amishasinghbauddh01/ECG-Signal-Acquisition-Circuit-using-Analog-Signal-Processing/ECG_Signal_Acquisition_Circuit.pdf

# Electrocardiogram (ECG) Signal Acquisition Circuit

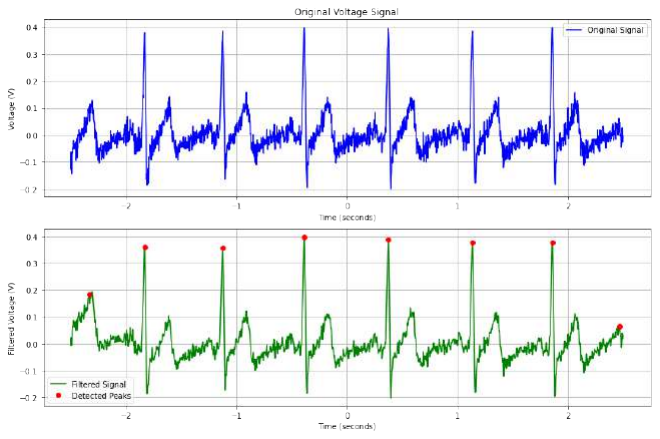
[picture p1: figure]

1

### B.Tech 4th Semester · Electronics & Communication Engineering Gati Shakti Vishwavidyalaya

### Project Report on Analog Circuits

### Submitted to: Dr. Anshika Srivastava

## Contents

1 Introduction | 4
2 Components Used | 4
3 Circuit Design Methodology | 4
4 Electrode Installation and Design Rationale | 6
5 Instrumentation Amplifier | 9
6 Notch Filter (50 Hz) | 17
7 Low-Pass Filter (LPF) | 26

2

7.5 Hardware Implementation | 29
7.6 Conclusion | 30
8 High-Pass Filter (HPF) | 31
8.1 Purpose | 31
8.2 Theory | 31
8.3 Simulation | 33
8.4 Hardware Implementation | 34
8.5 Conclusion | 36
9 Final Integration | 37
9.1 Simulated plots | 37
9.2 Hardware plots | 39
10 Testing on Humans | 41
10.1 Output Verification | 43
11 ECG Signal Acquisition and Processing | 44
12 Hardware Demonstration | 46
13 Conclusion | 46
13.1 Low-Cost and ADC Integration Potential | 46
13.2 Challenges and Observations | 47
13.3 Acknowledgements | 47
13.4 Code used for signal processing the CSV file | 48

3

## 1 Introduction

An electrocardiogram (ECG or EKG) records the electrical activity of the heart over time. The small voltages generated by the heart are picked up from electrodes placed on the skin and then amplified, filtered, and displayed using signal processing circuits. This project focuses on designing a low-cost ECG signal acquisition circuit using operational amplifiers and passive components, aimed at capturing clean ECG signals suitable for visualization or digitization.

## 2 Components Used

- UA741 Operational Amplifiers
- Resistors: various (10Ω – 1MΩ)
- Capacitors: ( 10nF - 10µF
- Electrodes (gel-based)
- Diodes (protection)
- Breadboard, digital oscilloscope, power supply

## 3 Circuit Design Methodology

The ECG signal acquisition circuit was designed in a modular fashion, following a systematic approach to address the challenges of weak signal amplification and noise rejection. Key design constraints and methodology are outlined below:

Design Constraints

- Signal Characteristics:

– Input signal range: 0.5 mV to 5 mV (typical ECG amplitude)

– Frequency bandwidth: 0.5 Hz to 150 Hz

– Maximum allowable gain error: ±5%

- Noise Requirements:

– Input-referred noise < 2 µVrms (for 0.5 Hz − 150 Hz)

– CMRR > 100 dB at 50 Hz

4

– Power-line rejection: > 40 dB at 50 Hz

- Power Constraints:

– Supply voltage: ±12 V (dual supply)

– Total current consumption < 10 mA

### 3.0.1 Design Approach

1. Electrode Interface:
- Used Ag/AgCl electrodes with conductive gel to maintain skin-contact impedance < 10 kΩ
- Implemented right-leg drive (RLD) circuit to reduce common-mode voltage
2. Instrumentation Amplifier (AD620):
- Selected gain G = 1000 via RG = 49.5 Ω (G = 1 + 49.4 kΩ
RG

)
- Limited bandwidth to 1 kHz to prevent high-frequency noise amplification
3. Filter Design:
- High-pass filter (fc = 0.5 Hz): Removed DC offsets while preserving ST segments
- Low-pass filter (fc = 150 Hz): Attenuated muscle noise (> 40 dB at 1 kHz)
- Twin-T notch filter (Q = 30 at 50 Hz): Achieved > 40 dB rejection
4. Output Stage:
- Added rail-to-rail output buffer to drive 10 kΩ loads
- Incorporated protection diodes against ±5 V ESD events

5

### 3.0.2 Design Verification

Performance was validated through:
- Frequency response analysis (Bode plots)
- Output heartrate verification with real heartbeat from digital smartwatch.
- CMRR testing with 45 mVpp common-mode signal
- Clinical validation using standard ECG simulator waveforms

The final design met all specified constraints while maintaining cost effectiveness.

## 4 Electrode Installation and Design Rationale

Installation Procedure The proper installation of ECG electrode probes is essential for acquiring clean, accurate signals. Typically, three electrodes are used in a basic ECG setup:
- One electrode on the right wrist (RA – Right Arm/Chest)
- One electrode on the left wrist (LA – Left Arm/Ches)
- One electrode on the right leg (RL – Right Leg, used as the ground/reference)

Before attaching the electrodes, the skin must be cleaned using alcohol wipes to remove oils and dead skin cells that can increase impedance and reduce signal quality. The electrodes should be pressed firmly onto the skin and connected securely using conductive gel pads or pre-gelled disposable ECG electrodes.

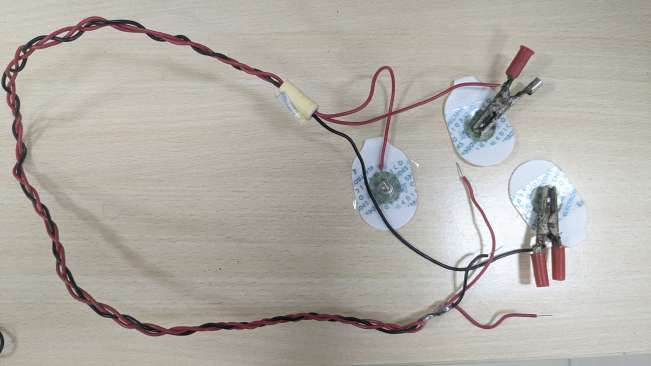
[picture p2: figure]

Figure 1: Electrodes. Observe the wire is braided to help reduce noise.

6

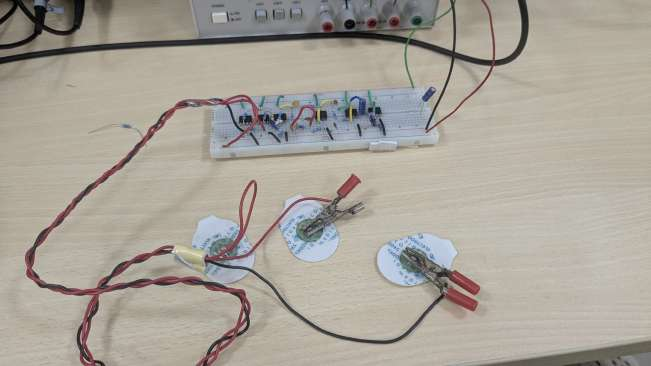
[picture p3: figure]

Figure 2: Complete circuit used for taking ECG readings.

### 4.1 Rationale for Placement

These positions are based on the Einthoven triangle model, which simplifies the heart’s electrical activity into three lead vectors forming a triangle. This model allows the detection of potential differences in different orientations of the heart’s depolarization wave, providing clinically useful ECG signals (especially Lead I, II, and III). Placement consistency is also critical for reproducibility and comparison between sessions or patients.

Importance of ECG Gel ECG gel is a conductive medium that fills the microscopic air gaps between the skin and the metal electrode. This reduces the skin-electrode contact impedance and prevents signal attenuation. Without gel, the high impedance interface may act like a high-pass filter and distort or attenuate the ECG signal, especially the low-amplitude P and T waves.

### 4.2 Parts of an Electrode Probe

An ECG electrode typically consists of the following components:

- Metallic contact (usually Ag/AgCl): Provides a stable, low-noise interface with the skin. Ag/AgCl electrodes are preferred due to their predictable electrochemical behavior and low offset voltage.
- Conductive gel: Facilitates ionic-to-electronic current conversion at the electrode-skin interface, reducing impedance and ensuring signal clarity.

7

- Adhesive backing: Ensures the electrode stays in place during measurement, minimizing motion artifacts.
- Snap or clip connector: Allows easy connection of lead wires from the circuit to the electrode. These must be securely fastened to prevent intermittent contact.

Why This Approach is Necessary Improper installation—such as dry electrodes, loose contacts, or incorrect placement—leads to high skin impedance, increased noise pickup (especially 50/60 Hz hum), baseline wandering, and even signal loss. Using gelled Ag/AgCl electrodes in the standard placement configuration ensures:

- High signal fidelity
- Low impedance coupling
- Reproducible measurements
- Protection against motion artifacts

Proper electrode use is foundational to any ECG measurement system, regardless of circuit quality. Even the best amplifier cannot recover lost or corrupted signals due to poor electrode contact or placement.

8

## 5 Instrumentation Amplifier

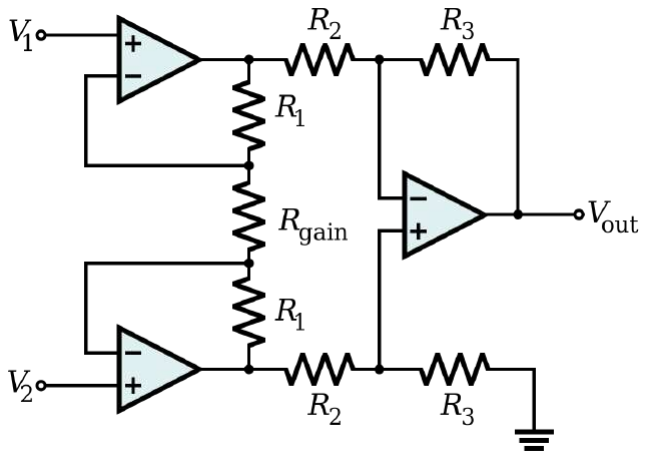
[picture p4: figure]

Figure 3: Instrumentation Amplifier Circuit, source : wikipedia

### 5.0.1 Purpose

Amplifies the weak ECG signal ( 0.5mV to 5mV) while rejecting common-mode interference (like 50/60 Hz noise, common mode noise from muscles). Electrocardiography (ECG) measures the electrical activity of the heart via electrodes placed on the skin. The resulting biopotential signals are typically in the range of 0.5–5 mV and are highly susceptible to various sources of noise, including muscle artifacts, electrode motion, and power-line interference. To accurately acquire these weak signals, instrumentation amplifiers (IAs) are the preferred choice for the front-end of ECG systems. The reasons are outlined below:

1. High Common-Mode Rejection Ratio (CMRR): One of the most important features of Instrumentation Amps in ECG is their ability to reject common-mode signals such as 50/60 Hz power-line interference. A high CMRR (typically > 100 dB) ensures that only the differential signal (i.e., the actual ECG waveform) is amplified.
2. High Input Impedance: ECG electrodes form a high-impedance interface with the skin. An amplifier with high input impedance prevents signal at-

9

tenuation due to loading effects and ensures accurate voltage measurements from the electrodes.

3. Low Noise and Offset: Given the low amplitude of ECG signals, an amplifier with low input-referred noise and minimal offset voltage is essential. Instrumentation Ampss are optimized for low-noise biomedical signal acquisition.
4. Differential Signal Acquisition: ECG signals are measured as differences between electrode potentials. Instrumentation amplifiers are designed for precise differential measurements, making them ideal for this application.
5. Precise and Stable Gain: IAs allow for easy and accurate gain setting through a single resistor, which is crucial when amplifying microvolt-level signals for digitization without distortion.

Other amplifier types, such as standard op-amps or differential amplifiers, may lack the necessary combination of CMRR, high input impedance, and low noise. Thus, instrumentation amplifiers are used in this particular implementation

### 5.0.2 Gain Derivation

The general three-op-amp configuration for an instrumentation amplifier is shown below. The gain of the circuit depends on the resistors in the feedback network and the gain-setting resistor.

General Gain Derivation for a Three-Op-Amp Configuration Consider the three-op-amp instrumentation amplifier with two input op-amps configured as buffers and a final difference amplifier stage. The gain formula can be derived as follows:
- Input-stage analysis: Each input op-amp holds its inverting node at the non-inverting voltage (virtual short). By applying nodal analysis, the output voltages from the first two op-amps are given by:

Vo1 =

1 +

R1
R2
V1 −

R1
R2

V2

Vo2 =

1 +

R1
R2
V2 −

R1
R2

V1

Here, V1 and V2 are the input signals.
- Difference-stage analysis: The third op-amp subtracts Vo1 from Vo2 with a feedback resistor R4 and an input resistor R3. The output voltage is:

VO =

R4
R3

(Vo2 − Vo1)

10

Combining the Equations By substituting the expressions for Vo1 and Vo2 into the final difference amplifier stage, the overall output voltage of the instrumentation amplifier becomes:

VO = (V2 − V1)

R4
R3
1 + 2

R1
R2

This gives the closed-loop differential gain G as:

G =

VO
V2 − V1

=

R4
R3
1 + 2

R1
R2

To ensure high common-mode rejection and maintain symmetry, the resistors in the final stage are typically chosen such that R3 = R4. With this simplification, the gain expression becomes:

G = 1 ·

1 + 2

R1
R2

Impact of UA741 on Instrumentation Amplifier Performance The nonideal characteristics of the UA741, particularly the input bias current and offset voltage, can lead to significant errors in the amplified signal, especially at higher frequencies. The limited bandwidth and slew rate also restrict the performance of the instrumentation amplifier at higher frequencies. These issues must be carefully considered when designing an INA with UA741 op-amps for precise ECG measurements, as higher freuqencies do not affect our circuit, we are operating in a frequency range from few Hz to 150 Hz only.

### 5.1 Theoretical Calculations

Given the gain formula for the instrumentation amplifier:

G = 1 +

2Rgain
RA
To achieve a gain of G = 900, rearrange the equation to solve for Rgain:

Rgain =

(G − 1) · RA
2
Substituting the given value RA = 47 Ω:

Rgain =

(900 − 1) · 47
2

=

899 · 47
2

≈ 21,128 Ω

Therefore, to achieve a gain of 900:
- Set RA = 47 Ω
- Set Rgain ≈ 21.13 kΩ

11

### 5.2 LTspice Simulations

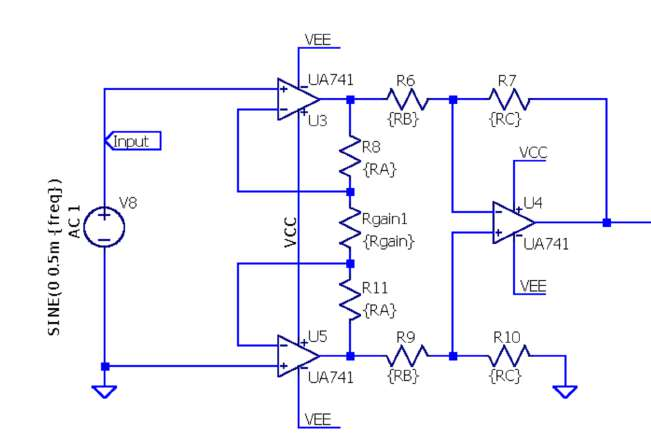
[picture p5: figure]

Figure 4: Instrumentation Amp circuit

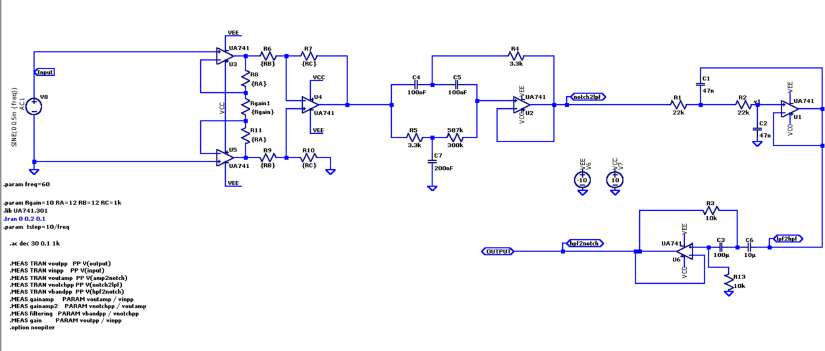
[picture p6: figure]

Figure 5: Instrumentation Amp circuit Output, gain = 861.3

12

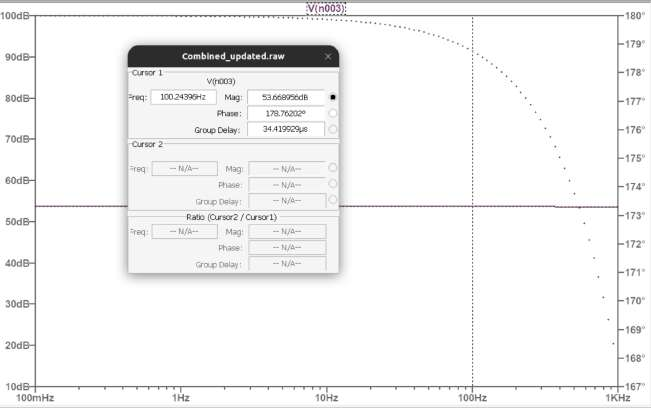
[picture p7: figure]

Figure 6: Instrumentation Amplifier Circuit Output ( Frequency plot, notice the phase shift at higher frequencies

13

### 5.3 Hardware implementations

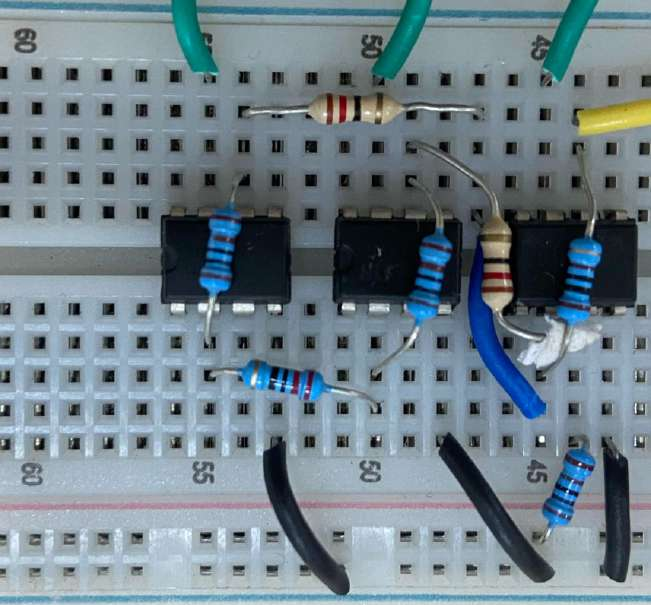
[picture p8: figure]

Figure 7: Hardware Implementation

14

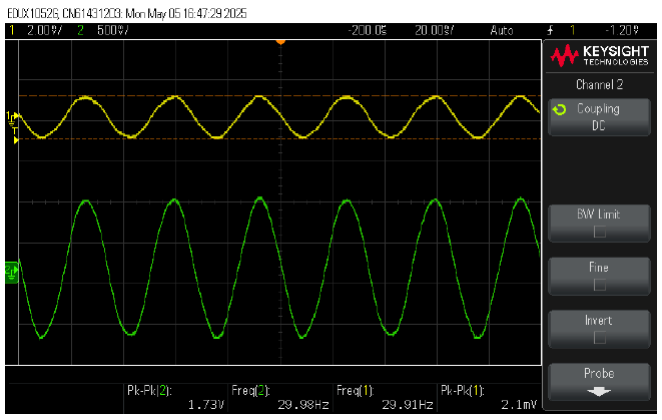
[picture p9: figure]

Figure 8: Gain = 823, hardware implementation Output

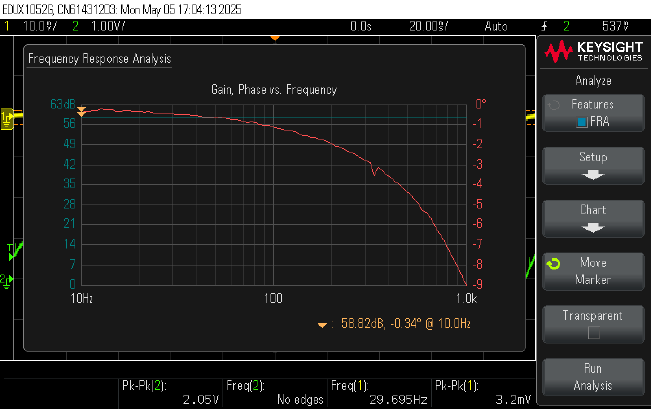
[picture p10: figure]

Figure 9: FRA of hardware implementation, notice rolloff of phase plot similar to simulation. however it doesnt affect us, as later seen we do not operate in that frequency

### 5.4 Noise Performance

Theoretically, the Common-Mode Rejection Ratio (CMRR) of an ideal instrumentation amplifier is infinite, as it perfectly rejects any common-mode signals.
In hardware, a common-mode voltage of 45 mV was applied, producing an

15 output of 1 mV. Hence common mode and diffrential mode gains are :

ACM =

Vout, CM

Vin, CM

=

1
45

, ADM = 820

The CMRR is calculated using the formula:

CMRR (dB) = 20 · log10
ADM
ACM | = 20 · log10 (820 · 45)

CMRR (dB) = 20 · log10(36900) ≈ 20 · 4.567 = 91.34 dB

Conclusion: The measured hardware CMRR is approximately 91.34 dB.

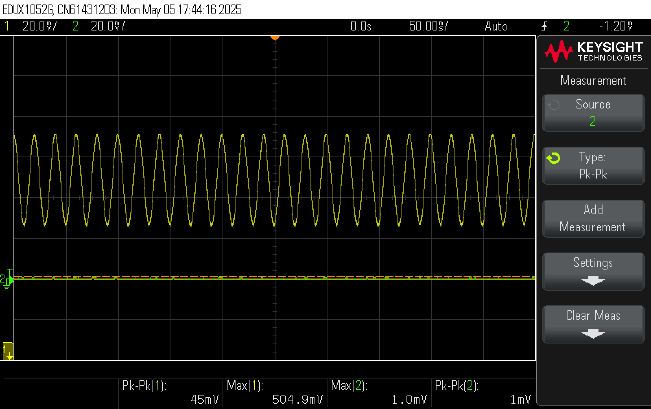
[picture p11: figure]

Figure 10: SNR measument for CMRR

### 5.5 Final Conclusion

INA using UA741 worked pretty well for our circuit. Although It did not work properly at high frequencies (phase shift) due to high slew rate of our op-amp. The expected gain of hardware circuit was consistent with the theory

### 5.6 Comparison Table ( theory, simulation, results)

Parameter | Theoretical Gain | Simulated Gain | Hardware Gain
Gain (G) | 900 | ∼ 860 | ∼ 810
CMRR | Ideal, infinite | - | Moderate (around 91.34dB)

16

## 6 Notch Filter (50 Hz)

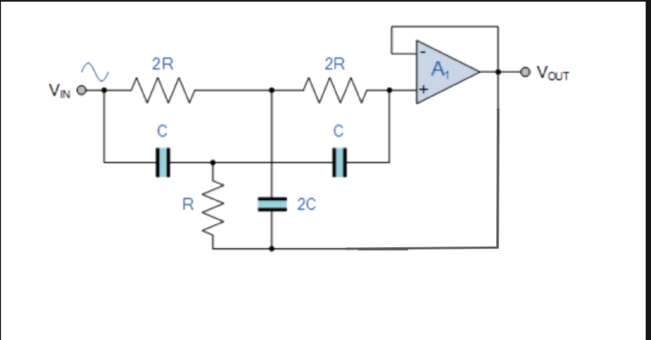
[picture p12: figure]

Figure 11: Twin T notch filter, source Electronics Tutorials WS

### 6.1 Purpose

Eliminates power-line interference centered at 50 Hz. This is especially important in ECG systems, where line noise overlaps the high-frequency content of the ECG signal, potentially corrupting it.

### 6.2 Twin-T Notch Filter Theory

The Twin-T notch filter is a well-known topology for suppressing a narrow frequency band while allowing most of the signal spectrum to pass. It is particularly suited for removing sinusoidal interference such as the 50 Hz power-line noise.

Structure and Working The Twin-T filter combines two T-shaped RC networks:

- A low-pass T-network (R-C-R): here, two resistors in series with a grounded capacitor between them.
- A high-pass T-network (C-R-C): two capacitors in series with a grounded resistor between them.

These two are connected in parallel. At the notch frequency f0, the outputs of the two branches are 180° out of phase and cancel each other, creating a deep notch in the response.

17

### 6.3 Derivation of Notch Frequency

Notch Frequency Derivation For a standard Twin-T notch filter, the theoretical center (notch) frequency is given by:

f0 =

1
2πRC

To achieve a notch at f0 = 50 Hz, we select component values satisfying the equation:
RC =

1
2πf0

=

1
2π · 50

≈ 3.183 × 10⁻³

In the lab, we choose standard capacitor values:

C = C4 = C5 = 100 nF = 100 × 10⁻⁹ F

Solving for R:

R =

1
2πf0C

=

1
2π · 50 · 100 × 10⁻⁹

≈ 31.83 kΩ

We use standard resistors:

R5 = R6 = 33 kΩ (nearest available value)

This gives a notch frequency very close to 50Hz:

f0 ≈

1
2π · 33 × 10³
- 100 × 10⁻⁹

≈ 48.3 Hz

We use the relationship between the quality factor (Q) and the resistors in the T-notch filter:

Q =

Rfeedback
R5
For R5 = 33 kΩ, the desired feedback resistor value gives:

Q =

300 kΩ
33 kΩ

≈ 9.09

Thus, we get a good quality factor of approximately 9.09,at the value of Rfeedback is selected to be 300 kΩ.

18

Notch Behavior At the notch frequency, the high-pass and low-pass T-networks produce outputs that are out of phase and cancel each other out at the junction, resulting in deep attenuation. The filter passes frequencies much lower and higher than f0, but significantly attenuates those near it.
To sharpen the notch and reduce losses due to component mismatches, we enhance the circuit using an op-amp (e.g., UA741) in a unity-gain feedback configuration. This:
- Restores signal amplitude outside the notch,
- Increases the quality factor (Q), narrowing the notch,
- Reduces sensitivity to component tolerance.

Final Component Choices

R5 = R6 = 33 kΩ
C4 = C5 = 100 nF
⇒ f0 ≈ 49.7 Hz ≈ 50 Hz

This configuration gives a clean, effective notch at 50Hz with standard lab components and minimal tuning.

### 6.3.1 Transfer Function of the Twin-T Notch Filter

The Twin-T notch filter is designed to attenuate a specific frequency while allowing others to pass with minimal attenuation. Its transfer function characterizes this behavior and is given by:

H(s) = s

2 + ω

2
0
s
| 2 +

ω0
Q

s + ω

2
0
Where:
- H(s) is the transfer function in the Laplace domain.
- s = jω is the complex frequency variable.
- ω0 = 2πf0 is the notch angular frequency.
- Q is the quality factor, determining the sharpness of the notch.

At the notch frequency ω = ω0, the numerator becomes zero, resulting in:

H(jω0) = 0

This indicates complete attenuation at the notch frequency.

| 19

### 6.3.2 Bode Plot Analysis

The Bode plot comprises two graphs:

1. Magnitude Plot: Shows how the amplitude of the output signal varies with frequency.
2. Phase Plot: Illustrates the phase shift introduced by the filter across frequencies.

For the Twin-T notch filter:

- Below and Above Notch Frequency: The magnitude remains close to unity (0dB), indicating minimal attenuation.
- At Notch Frequency (f0): The magnitude drops sharply, ideally reaching negative infinity in dB, signifying complete attenuation.
- Phase Response: Exhibits a rapid phase shift around the notch frequency, transitioning from 0° to -180°, which is characteristic of notch filters.

The sharpness and depth of the notch are governed by the quality factor Q. A higher Q results in a narrower and deeper notch, effectively attenuating a very specific frequency range.

### 6.3.3 Active Twin-T Filter with UA741

An op-amp (UA741) is used in a unity-gain feedback mode to:

- Buffer the filter and isolate it from surrounding stages
- Increase the Q-factor (sharpen the notch)
- Restore gain lost due to insertion loss

20

### 6.4 Simulation

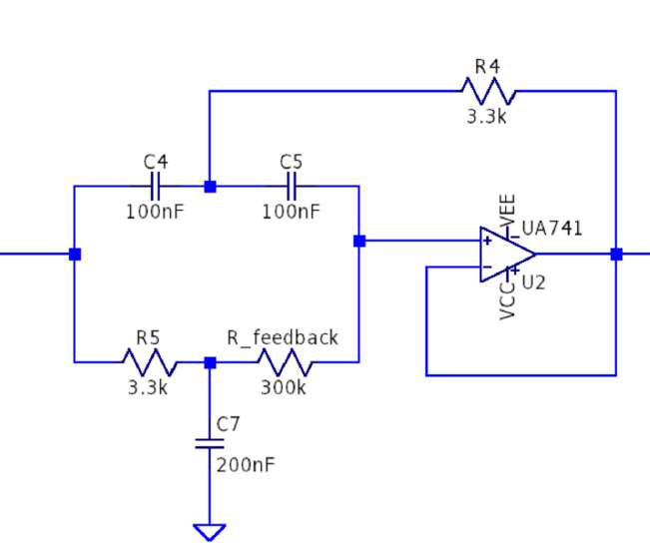
[picture p13: figure]

Figure 12: LTSpice Circuit

21

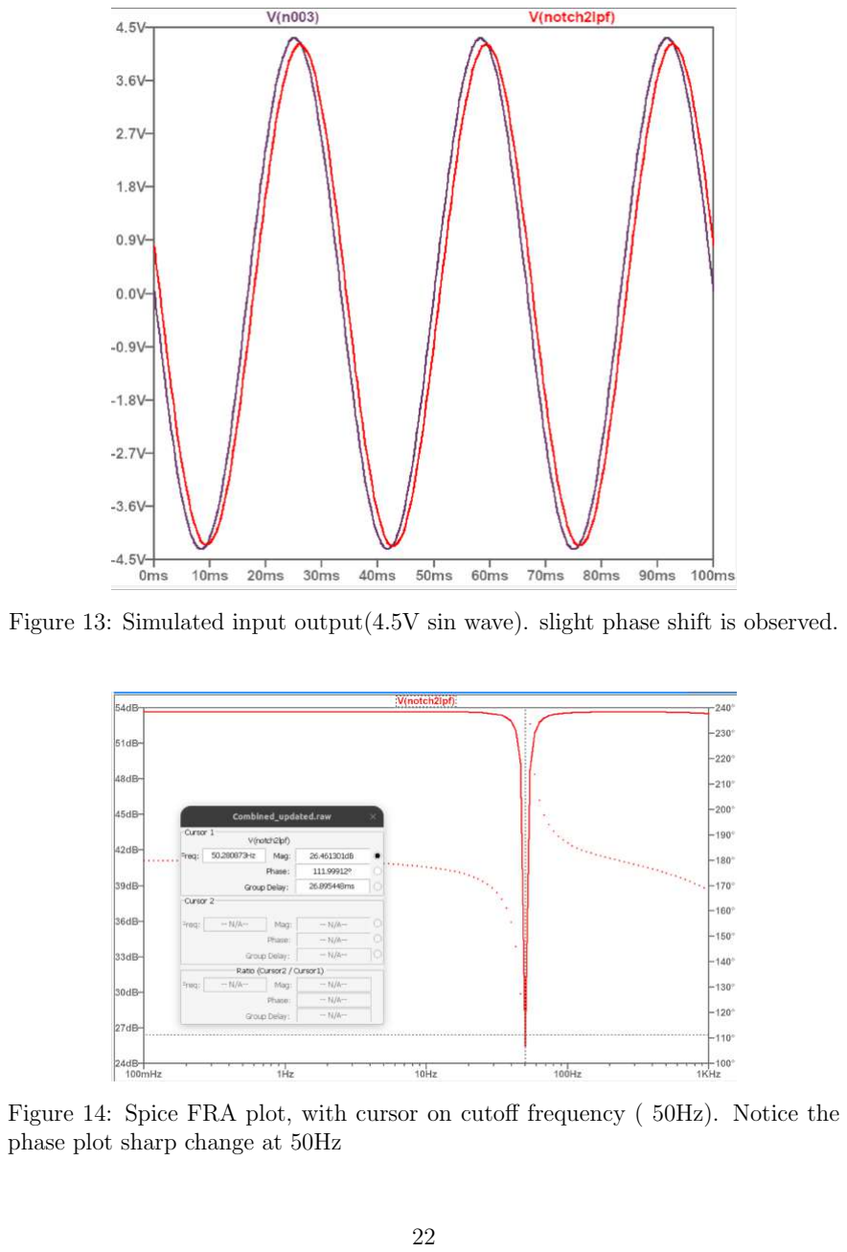
[picture p14: page 22]

Figure 13: Simulated input output(4.5V sin wave). slight phase shift is observed.

Figure 14: Spice FRA plot, with cursor on cutoff frequency ( 50Hz). Notice the phase plot sharp change at 50Hz

22

### 6.5 Hardware implementation

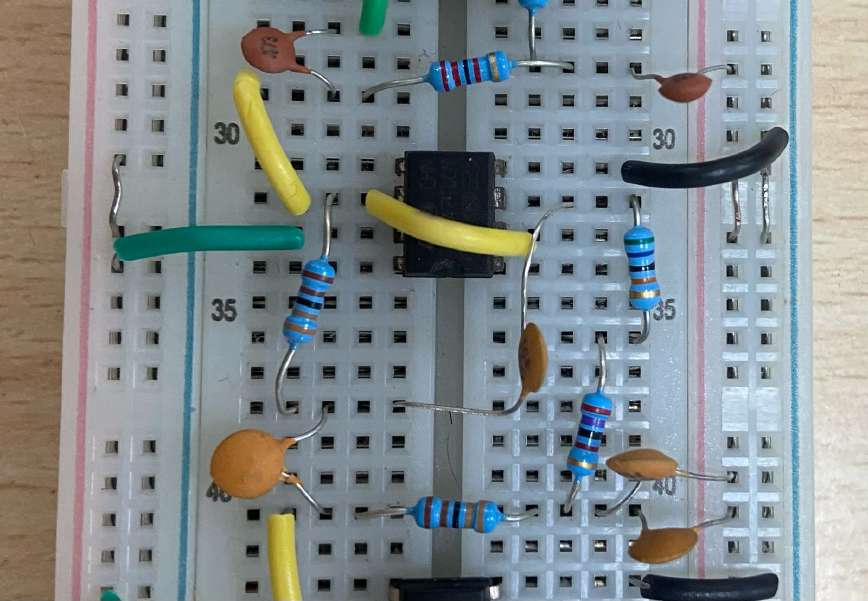
[picture p15: figure]

Figure 15: Enter Caption

23

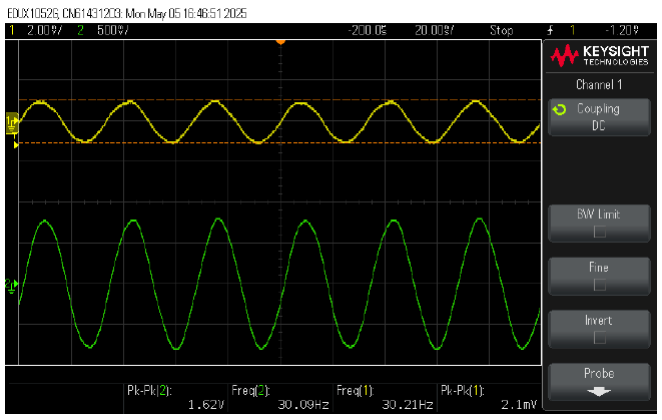
[picture p16: figure]

Figure 16: Hardware sim output. previous stage output was 1.72Vpp - gain of 0.9451

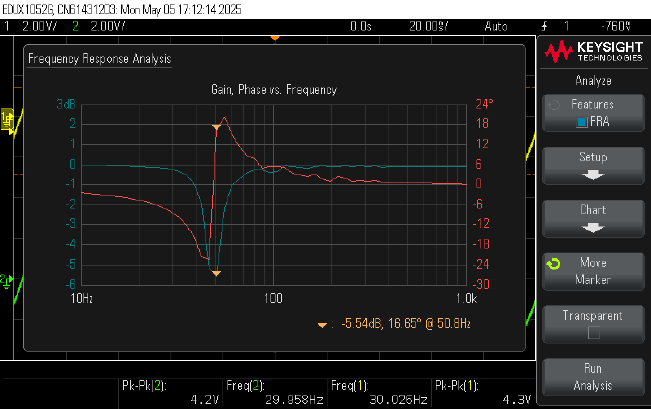
[picture p17: figure]

Figure 17: FRA of hardware implentation

### 6.5.1 Hardware Realization and Challenges

- Realizing this notch filter in hardware was non-trivial due to the sensitivity of the center frequency to resistor and capacitor tolerances.
- Small deviations caused noticeable frequency shifts. This was primarily due to changes in input/output impedance between op-amp and passive branches.

24

- In hardware, we needed to add an additional resistance of approximately 15 Ω to match the simulation behavior. This adjustment was determined via trial-and-error.

### 6.6 Conclusion

The Twin-T notch filter, enhanced with the UA741 op-amp, provides sharp 50 Hz suppression suitable for biomedical signals like ECG. Though simulation gave accurate results, practical implementation required careful tuning due to the sensitivity of the circuit to component variations and impedance mismatches. with a gain of 0.9451.

25

## 7 Low-Pass Filter (LPF)

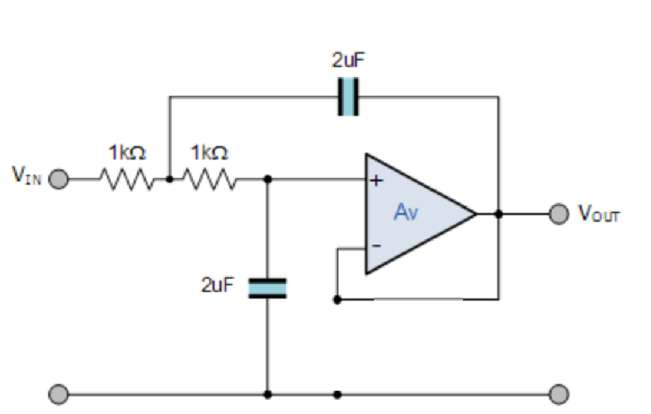
[picture p18: figure]

Figure 18: @nd Order LPF circuit, source Electronics stack exchange

### 7.1 Purpose

A low-pass filter (LPF) is used to suppress high-frequency noise like muscle artifacts (EMG) and electromagnetic interference (EMI), preserving the ECG signal in the typical range of 0.5–100 Hz.

### 7.2 Theory

A basic passive LPF has a resistor R in series and a capacitor C to ground. Its Laplace-domain transfer function is:

HLP(s) = | 1
| sCR + 1

Substituting s = jω, we get:

|HLP(jω)| =

| 1
p
| 1 + (ωRC)

2

The cutoff frequency is:

ωc =

1
RC , fc =

1
2πRC

26

For R = 22kΩ = 22 × 10³ Ω, C = 47nF = 47 × 10⁻⁹ F:

RC = 22 × 10³ × 47 × 10⁻⁹ = 1.034 × 10⁻³ s

fc =

1
2π · RC =

1
2π · 1.034 × 10⁻³

≈ 154 Hz

The phase response is:

̸ HLP(jω) = − tan⁻¹
(ωRC)

### 7.3 First- vs. Second-Order LPF

A second-order LPF (e.g., Sallen-Key configuration) has a sharper roll-off of 40 dB/decade and can provide improved attenuation of high-frequency components. It uses two resistors and two capacitors along with an op-amp. The transfer function is:

H(s) = | 1

1 + s
| ω0Q +
s
ω0

2

where:

ω0 =

1
√
R1R2C1C2

, Q =

√
R1R2C1C2
R1C1 + R2C1 + R2C2

using: R1 = R2 = 22kΩ, C1 = C2 = 47nF, available in Lab

ω0 =

1
p
(22 × 10³
)

2

- (47 × 10⁻⁹
)

2

| =

1
| 22 × 10³
- 47 × 10⁻⁹

≈ 968 rad/s

f0 =

ω0
2π

≈

968
2π

≈ 154 Hz

Q =

√
R1R2C1C2
R1C1 + R2C1 + R2C2
= | RC RC + RC + RC =
1
3

≈ 0.333

27

### 7.4 Simulation

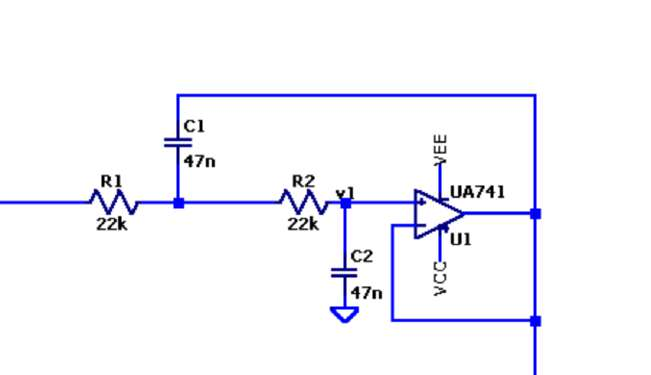
[picture p19: figure]

Figure 19: LPF LTspice circuit

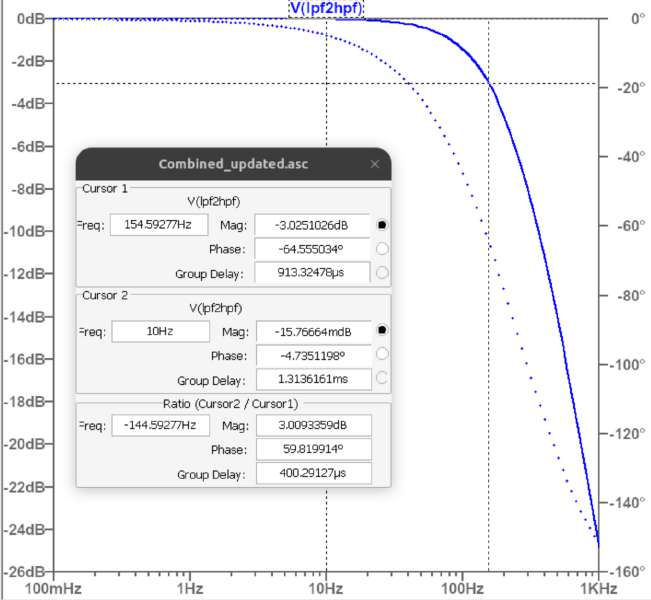
[picture p20: figure]

Figure 20: LPF simulation output, cutoff 154Hz

28

### 7.5 Hardware Implementation

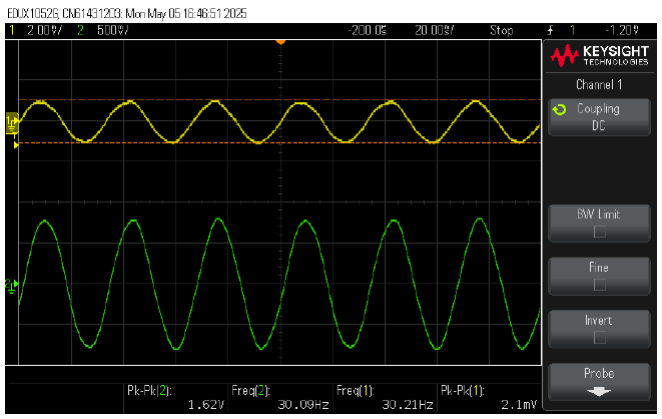
[picture p21: figure]

Figure 21: Output to a sinousoidal signal, almost save voltage ( 0.01V) diffrence between input and output stage. ( yellow shows input to Instrumentation amp, please ignore

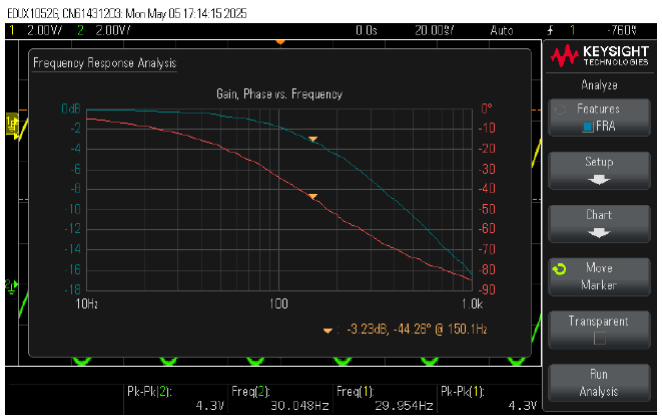
[picture p22: figure]

Figure 22: FRA showing cutoff at 150Hz

29

### 7.6 Conclusion

The LPF ensures high-frequency noise does not distort the ECG signal. Second-order filters offer better suppression at higher frequencies. With the given component values, a cutoff frequency of approximately 154 Hz is achieved. The second-order configuration further provides a quality factor of about 0.333, offering smoother and sharper attenuation beyond the cutoff. Due to errors, the actual cutoff frequency in hardware was 150Hz, which is within acceptable margin of error.

30

## 8 High-Pass Filter (HPF)

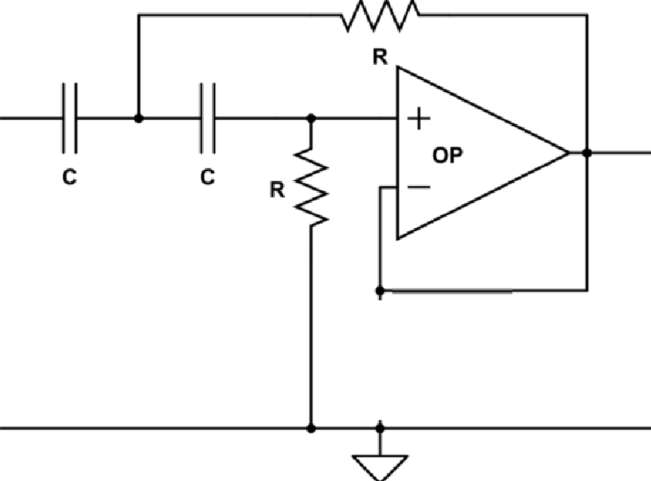
[picture p23: figure]

Figure 23: 2nd order HPF circuit. Source eeeguide.com

### 8.1 Purpose

A high-pass filter (HPF) is used to suppress low-frequency noise and baseline wander (such as breathing artifacts or DC offsets) while preserving the useful ECG signal above the typical threshold of 0.5–1 Hz.

### 8.2 Theory

A basic passive HPF consists of a capacitor C in series followed by a resistor R to ground. Its Laplace-domain transfer function is:

HHP(s) = | sRC
| 1 + sRC
Substituting s = jω, the magnitude response becomes:

|HHP(jω)| =

| ωRC
p
| 1 + (ωRC)

2

The cutoff frequency is given by:

ωc =

1
RC , fc =

1
| 2πRC

31

For R = 20 kΩ = 10 × 10³ Ω, C = 100 µF = 100 × 10⁻⁶ F:

RC = 20 × 10³ × 100 × 10⁻⁶ = 2 s

fc =

1
2π · RC =

1
2π · 2

≈ 0.785 Hz

To get a sharper roll-off, a second-order HPF is used. The Sallen-Key configuration with two capacitors and two resistors has the following transfer function:

H(s) = | s

2
s
| 2 + ω0 Q
s + ω

2
0

where:

ω0 =

1
√
R1R2C1C2

, Q =

√
R1R2C1C2
| R1C2 + R1C1 + R2C2

Using: R1 = R2 = 20 kΩ, C1 = 10 µF, C2 = 100 µF:

RC = 20 × 10³ × 10 × 10⁻⁶ = 0.2 s

ω0 =

1
p
(20 × 10³
)

2

- 10 × 10⁻⁶
| · 100 × 10⁻⁶

=

1
√
4 × 10⁸
- 10⁻³

=

1
√
4 × 10⁵

=

1
632.46

≈ 1.58 rad/s

f0 =

ω0
2π

≈

1.58
2π

≈ 0.251 Hz

Q =

632.46
20 × 10³
- (100 + 10 + 100) × 10⁻⁶

=

632.46
20 × 10³
- 210 × 10⁻⁶

=

632.46
4.2

≈ 0.15

32

### 8.3 Simulation

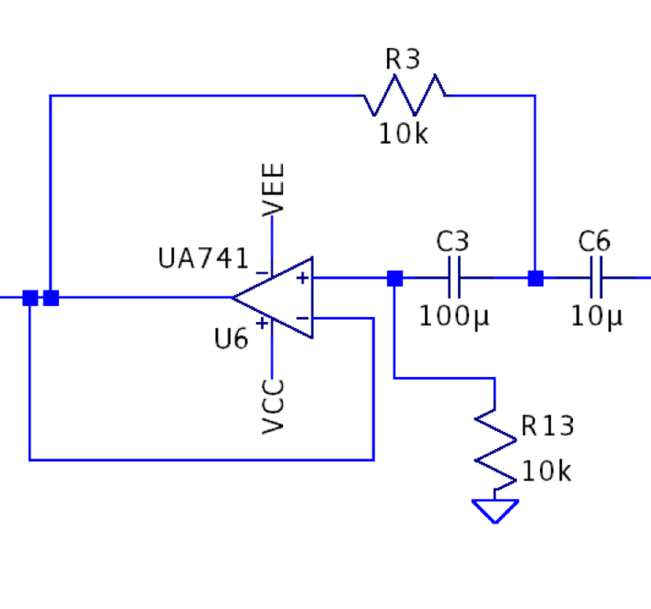
[picture p24: figure]

Figure 24: HPF circuit. Please note it’s in reverse direction from reference diagram

33

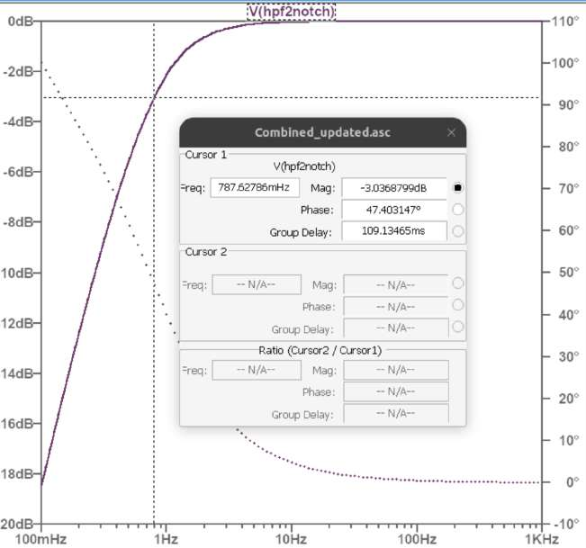
[picture p25: figure]

Figure 25: HPF simulation BODE plot.

### 8.4 Hardware Implementation

The DSO doesnt support such low frequencies we are dealing with. So we had to manually supply frequency using wavegen and compare.

34

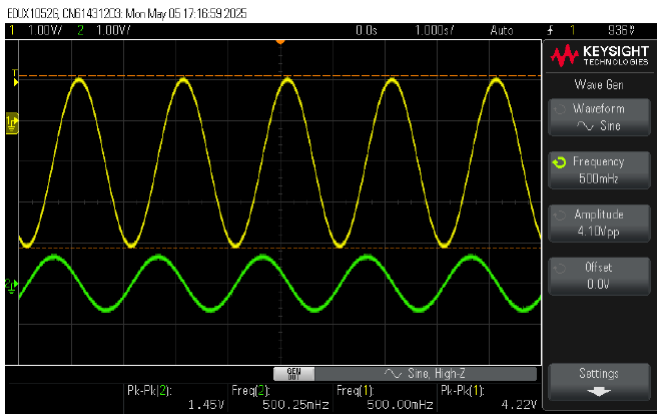
[picture p26: figure]

Figure 26: attenuating to 1.45V for 4.2V input at 500mHz

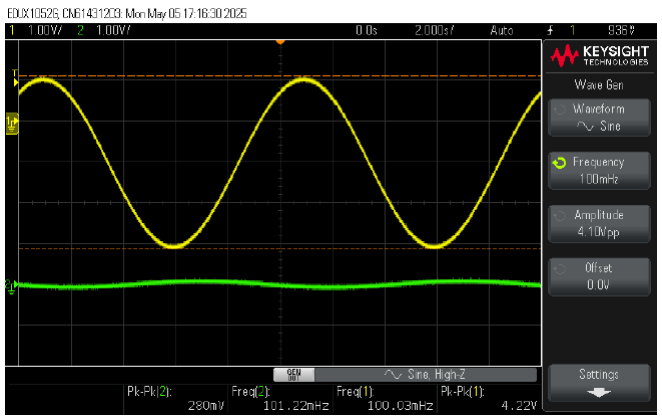
[picture p27: figure]

Figure 27: attenuating to 280mV for 4.2V input at 100mHz

35

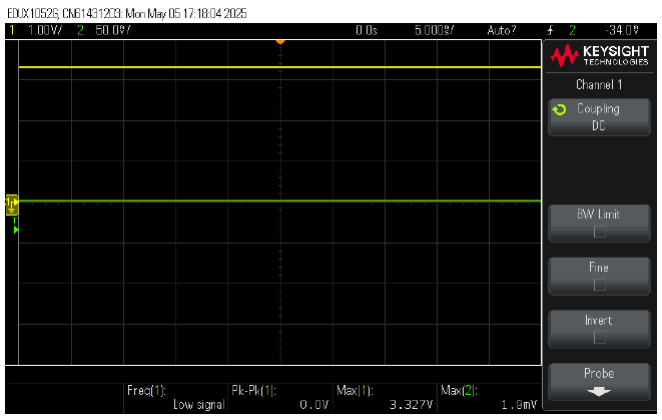
[picture p28: figure]

Figure 28: 1.9mV output for a DC input of 3.3V ( blocking 0 Hz frequency )

### 8.5 Conclusion

The HPF is effective in eliminating baseline drift and very low-frequency components such as those introduced by patient movement or respiration. The actual hardware implementation closely matches the simulation, with a measured cutoff of approximately 0.47–0.5 Hz using available lab components. Slight variations are acceptable due to capacitor tolerances and input impedance mismatches.

36

## 9 Final Integration

### 9.1 Simulated plots

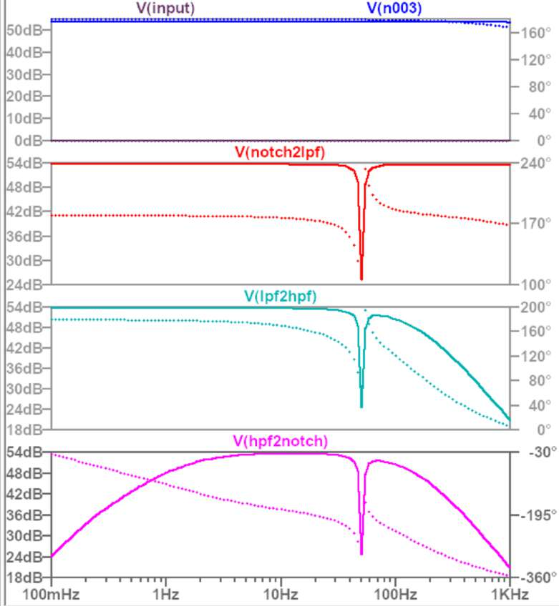
[picture p29: figure]

Figure 29: Plots of FRA of various stages

37

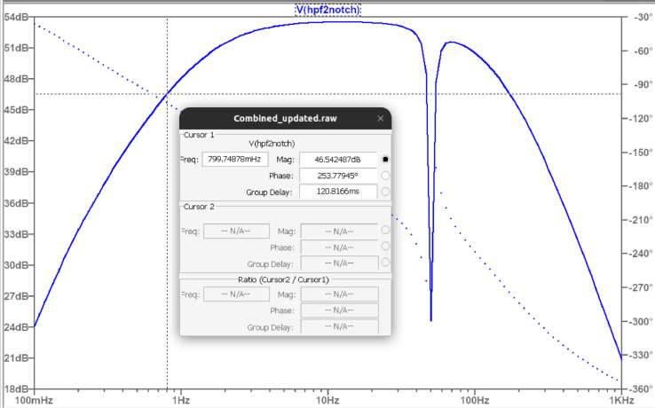
[picture p30: figure]

Figure 30: Final FRA plot, showing bandpass behaviour and notch filtering

Figure 31: Full circuit in Spice

38

### 9.2 Hardware plots

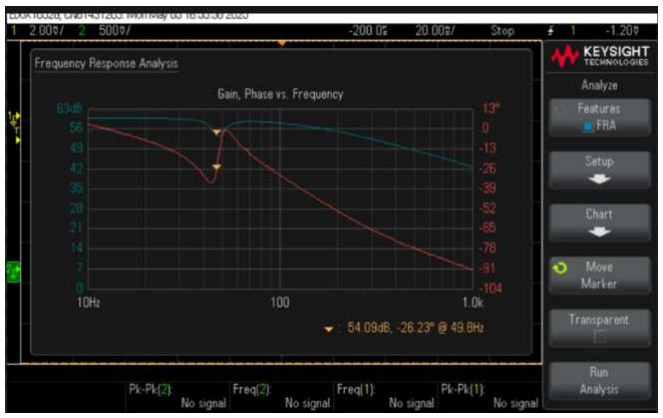
[picture p31: figure]

Figure 32: Plot showing notch at 49.8Hz

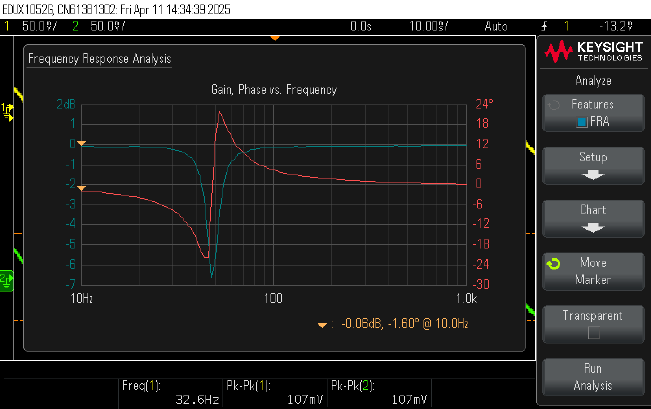
[picture p32: figure]

Figure 33: FRA plot of notch filter, howing proper notch

39

Table 1: Summary of Theoretical, Simulated, and Hardware Results for Each Filter Stage

Filter Stage | Theoretical Output | Simulated Output | Hardware Output
Notch Filter (50 Hz) | Notch at 50 Hz, Q ≈ 9.09, f0 ≈ 49.7 Hz | Deep notch at 50 Hz, phase shift observed | Notch near 50 Hz, Gain ≈ 0.9451, slight frequency shift due to toler-ances
Low-Pass Filter | Cutoff fc ≈ 154 Hz, 2nd order, Q ≈ 0.333 | Cutoff at 154 Hz, clean roll-off | Cutoff at ∼150 Hz, mi-nor voltage drop (0.01V), matches simu-lation
High-Pass Filter | Cutoff fc ≈ 0.08 Hz (R = 20kΩ, C = 100µF) | Passes signal above 0.1 Hz, attenuates DC component | Cutoff near 0.5 Hz, removes baseline wander due to breath-ing, slight phase shift

40

## 12 Demonstration

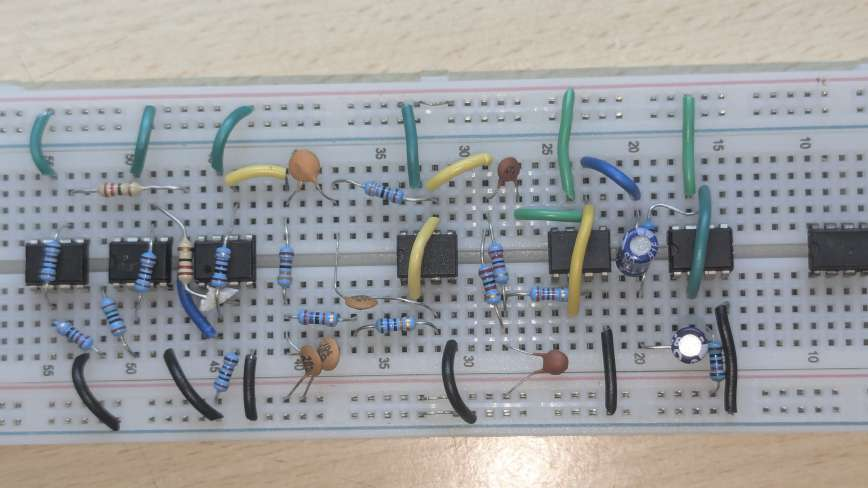
[picture p33: figure]

Figure 40: Complete Circuit Image

## 13 Conclusion

The ECG signal acquisition and processing circuit developed in this project demonstrated the capability to extract meaningful cardiac signals using an analog front-end composed of amplification, filtering, and noise reduction stages. The results show that even with basic components and careful design, one can retrieve a relatively clean ECG waveform suitable for analysis. The performance was validated across theoretical, simulated, and hardware stages, proving the effectiveness of the design approach.

### 13.1 Low-Cost and ADC Integration Potential

This low-cost ECG device is not only affordable and easy to build but also functions effectively as a preliminary stage for further digitization. Its signal conditioning

46

# Picture

The image below shows the complete ECG circuit assembled on a breadboard.

capabilities make it an excellent candidate for feeding into an ADC (Analog-to-Digital Converter), paving the way for integration with digital ECG processing systems, mobile health monitors, or embedded systems. Given its simplicity and affordability, the circuit can serve as an educational tool or even a prototype in wearable health tech development.

### 13.2 Challenges and Observations

Several practical challenges were encountered throughout the project. Signal acquisition was particularly sensitive to noise, requiring careful probe placement and shielding. Muscle artifacts and environmental interference (especially 50/60 Hz mains noise) posed filtering challenges. While bandpass filtering helped, finetuning the cutoff frequencies without distorting the QRS complex proved tricky. In addition, variability in skin-electrode contact and the use of makeshift probes often led to inconsistent signal amplitudes and occasional baseline wandering, which was later fixed using a high pass filter. These issues highlight the importance of both robust hardware and algorithmic post-processing in practical biomedical systems.

### 13.3 Acknowledgements

We would like to sincerely thank our course instructor Prof Spandan, Prof Arti & Prof Madhav , teaching assistants ( especially our alloted TA, Mallika Garg) and Lab assitants, Gopal Rao Sir and Prashant Sir for their guidance, timely feedback, and support throughout the project. Their insights were critical in helping us troubleshoot circuit issues, understand the underlying physiology, and push the project toward a successful outcome.

## References

[1] Electronics Tutorials. ”Butterworth Filter Design - Basic Electronics Tutorials and Revision.” Electronics Tutorials, n.d. Available: https://www.electronics-tutorials.ws/filter/filter_8.html. Accessed: May 5, 2025.
[2] All About Circuits. ”An Introduction to Filters - Technical Articles.” All About Circuits, n.d. Available: https://www.allaboutcircuits.com/technical-articles/an-introduction-to-filters/. (https://www.allaboutcircuits.com/technical-articles/an-introduction-to-filters/) Accessed: May 5, 2025.

47

[3] Texas Instruments. ”Instrumentation Amplifiers — TI.com.” Texas Instruments, n.d. Available: https://www.ti.com/amplifier-circuit/instrumentation/overview.html. (https://www.ti.com/amplifier-circuit/instrumentation/overview.html) Accessed: May 5, 2025.
[4] BIOPAC Systems. ”ECG Guide.” BIOPAC Systems, n.d. Available: https: //www.biopac.com/wp-content/uploads/ECG-Guide.pdf. Accessed: May 5, 2025.
[5] Mindray. ”Mindray ECG Lead Placement Quick Reference Guide.” Mindray, n.d. Available: https://www.mindray.com/content/dam/xpace/en_us/service-and-support/training-and-education/resource--library/modality/quick-reference-guides-1/Mindray-ECG-Lead-Place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. (https://www.mindray.com/content/dam/xpace/en_us/service-and-support/training-and-education/resource--library/modality/quick-reference-guides-1/Mindray-ECG-Lea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) Accessed: May 5, 2025.

48
