amishasinghbauddh01/ECG-Signal-Acquisition-Circuit-using-Analog-Signal-Processing/ECG_Project.asc

C1: cap; 104n
C2: cap; 224n
C3: cap; 104n
C4: cap; 47n
C5: cap; 47n
C6: cap; 10µ
C7: cap; 100µ
R1: res; {RA}
R2: res; {RA}
R3: res; {Rgain}
R4: res; {RB}
R5: res; {RB}
R6: res; {RC}
R7: res; {RC}
R8: res; 3.3k
R9: res; 330k
R10: res; 3.3k
R11: res; 22k
R12: res; 22k
R13: res; 10k
R14: res; 10k
U1: opamp2; UA741
U2: opamp2; UA741
U3: opamp2; UA741
U4: opamp2; UA741
U5: opamp2; UA741
U6: opamp2; UA741
V2: signal; SINE(0 20m {freq}); AC 1
Vcc: voltage; 9
Vee: voltage; -9
Named nets: 0, input, Vee, Vcc, notch2lpf, output, hpf2notch, lpf2hpf
.param freq=60
.param Rgain=1k RA=12k RB=1k RC=33k
; .tran 0 0.2 0.1
.ac dec 30 0.1 1k
.param tstep=10/freq
; .MEAS TRAN voutpp PP V(output)
; .MEAS TRAN vinpp PP V(input)
; .MEAS TRAN voulamp PP V(amp2notch)
; .MEAS TRAN vnotchpp PP V(notch2lpf)
; .MEAS TRAN vbandpp PP V(bpf2notch)
; .MEAS gainamp PARAM voulamp / vinpp
; .MEAS gainamp2 PARAM vnotchpp / voulamp
; .MEAS filtering PARAM vbandpp / vnotchpp
; .MEAS gain PARAM voutpp / vinpp
; .option noopiler
.lib UA741.301
